coredump-ch/dancepads/Elektronik/2017/Stückliste.xlsx

Bauteil | Menge | Name | Beschreibung | Gehäuse | Kaufort
U1 | 1 | PIC18F23K22-I/SS | Microcontroller | SSOP-28 | http://ch.farnell.com/microchip/pic18f23k22-i-ss/mcu-8bit-pic18f-64mhz-ssop-28/dp/2315851
U2 | 1 | MCP2221A | USB-I2C converter | TSSOP-14 | http://ch.farnell.com/microchip/mcp2221a-i-st/interface-br-cke-usb-zu-i2c-uart/dp/2678461
C1 | 1 | 10 uF Keko | Stützkondensator | 0805 | http://ch.farnell.com/murata/grm21br61c106ke15k/kondensator-mlcc-x5r-10uf-16v/dp/2611940
C2 | 1 | 470 nF Keko | Stützkondensator | 0603 | http://ch.farnell.com/walsin/0603f474z160ct/kondensator-mlcc-y5v-0-47uf-16v/dp/2496876RL
C3, C16 | 2 | 100 nF Keko | Stützkondensator | 0603 | http://ch.farnell.com/kemet/c0603c104k4rac7081/kondensator-mlcc-x7r-0-1uf-16v/dp/2522597RL
U3 | 1 | NC7SZ332 | OR-Gate | SC-70 | http://ch.farnell.com/on-semiconductor/nc7sz332p6x/ic-sm-logik-nc7sz-or-gate/dp/1607793
J1, J2, J3 | 3 | 68021-208HLF | Verbindung Slave-Slave IN | 2.54 mm Stiftleiste 8-Pin | http://ch.farnell.com/amphenol-fci/68021-208hlf/board-to-board-header-8-position/dp/1924210
J4 | 1 | SSW-104-02-G-D-RA | Verbindung Slave-Slave OUT | 2.54 mm Stiftbuchse 8-Pin | http://ch.farnell.com/samtec/ssw-104-02-g-d-ra/buchse-2-54mm-90-zwei-8kont/dp/1668343
LED1, LED2 | 2 | 1.6x0.8mm SMD CHIP LED LAMP | LED Rot | 0603 | http://ch.farnell.com/kingbright/kp-1608src-prv/led-red-30mcd-640nm-smd/dp/2463989
R5, R6 | 2 | 150 Ohm R | Vorwiderstand | 0603 | ch.farnell.com/multicomp/mcwr06x1500ftl/dickschichtwiderstand-150-ohm/dp/2447255RL
J5 | 1 | USB B | USB Stecker | USB-B | http://ch.farnell.com/multicomp/usb-b-s-ra/usb-2-0-buchse-typ-b-tht/dp/2112373?MER=sy-me-pd-mi-alte
R13, R14, R15 -22, R43 - 45 | 13 | 10 kOhm R | Pull up Widerstand | 0603 | http://ch.farnell.com/multicomp/mcwr06x1002ftl/dickschichtwiderstand-10k-1-0/dp/2447230
J6 | 1 | 68016-106HLF | Programmierverbindung | 2.54 mm Stiftleiste 6-Pin | http://ch.farnell.com/amphenol-fci/68016-106hlf/steckv-stiftleiste-6pos-1-reihe/dp/2751386
D9, D10, D11, D12 | 4 | BZV55-C4V7 | Zenerdiode | SOD-80C | http://ch.farnell.com/nexperia/bzv55-c4v7-115/zener-diode-0-5w-4-7v-sod-80c/dp/1097200RL
D1 - 3, D9 - 12, D17 - 20 | 12 | CD0603-B0340R | Shottky Diode | 0603 | http://ch.farnell.com/bourns/cd0603-b0340r/schottky-diode-1fach-40v-0603/dp/2807975
LED3 - 6 | 4 | ASMT-YTD7-0AA02 | RGB-LED | Speziell | http://ch.farnell.com/broadcom-limited/asmt-ytd7-0aa02/led-plcc6-rgb-650-1900-384-mcd/dp/2368162
Q5 - Q7 | 3 | SSM3K7002F | Treiber FET | SOT23 | http://ch.farnell.com/toshiba/ssm3k7002f-t5l-f-t/mosfet-n-kanal-0-2a-60v-sot23/dp/1714383
R27 & 28, R30 & 31, R33 & 34, R36 &37 | 8 | 47 Ohm R | Vorwiderstand | 0603 | http://ch.farnell.com/multicomp/mcwr06x47r0ftl/dickschichtwiderstand-47r-1-0/dp/2447378
R9, R29, R32, R35 | 4 | 120 Ohm R | Vorwiderstand | 0603 | http://ch.farnell.com/multicomp/mcwr06x1200ftl/dickschichtwiderstand-120-ohm/dp/2447240
 | 4 | Piezos | 7BB-20-6 | 2 Pins | https://www.distrelec.ch/de/piezo-element-murata-7bb-20/p/13787033?q=*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
Einmalig:
 | 1 | PICkit 3 |  |  | http://ch.farnell.com/microchip/pg164130/debugger-pickit-3-usb-programmer/dp/1771323
 | 10 | Piezos | 7BB-12-9 | 0.378 | https://www.distrelec.ch/de/piezo-element-murata-7bb-12/p/13787017?q=*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
 | 10 | Piezos | 7BB-15-6 | 0.2592 | https://www.distrelec.ch/de/piezo-element-murata-7bb-15/p/13787025?q=*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
 | 10 | Piezos | 7BB-20-6 | 0.5076 | https://www.distrelec.ch/de/piezo-element-murata-7bb-20/p/13787033?q=*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
 | 10 | Piezos | 7BB-20-6L0 | 1.22 | https://www.distrelec.ch/de/piezo-element-murata-7bb-20-6l0/p/13787041?q=*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
 | 10 | Piezos | 7BB-27-4 | 0.972 | https://www.distrelec.ch/de/piezo-element-murata-7bb-27/p/13787058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
 | 10 | Piezos | 7BB-35-3 | 0.6912 | https://www.distrelec.ch/de/piezo-element-murata-7bb-35/p/13787066?q=*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
 | 10 | Piezos | 7BB-35-3C | 1.3 | https://www.distrelec.ch/de/piezo-element-murata-7bb-35-3c/p/13787074?q=*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
