coredump-ch/dancepads/Elektronik/2014_old/Schema+PCB/LED_Adapter.step

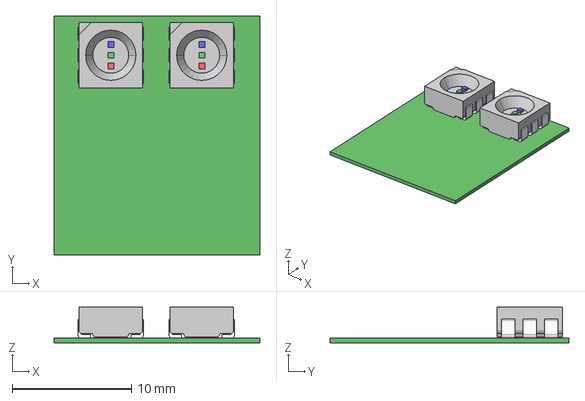
[picture p2: CAD file, 2017-11-20, an earlier design]
Elektronik/2014_old/Schema+PCB/LED_Adapter.step
17.2 x 20.0 x 2.98 mm
Board
User_Library-Cree_PLCC6_LED_model x 2
