coredump-ch/dancepads/Elektronik/2017/Layout/Layout_Dancepad.pdf

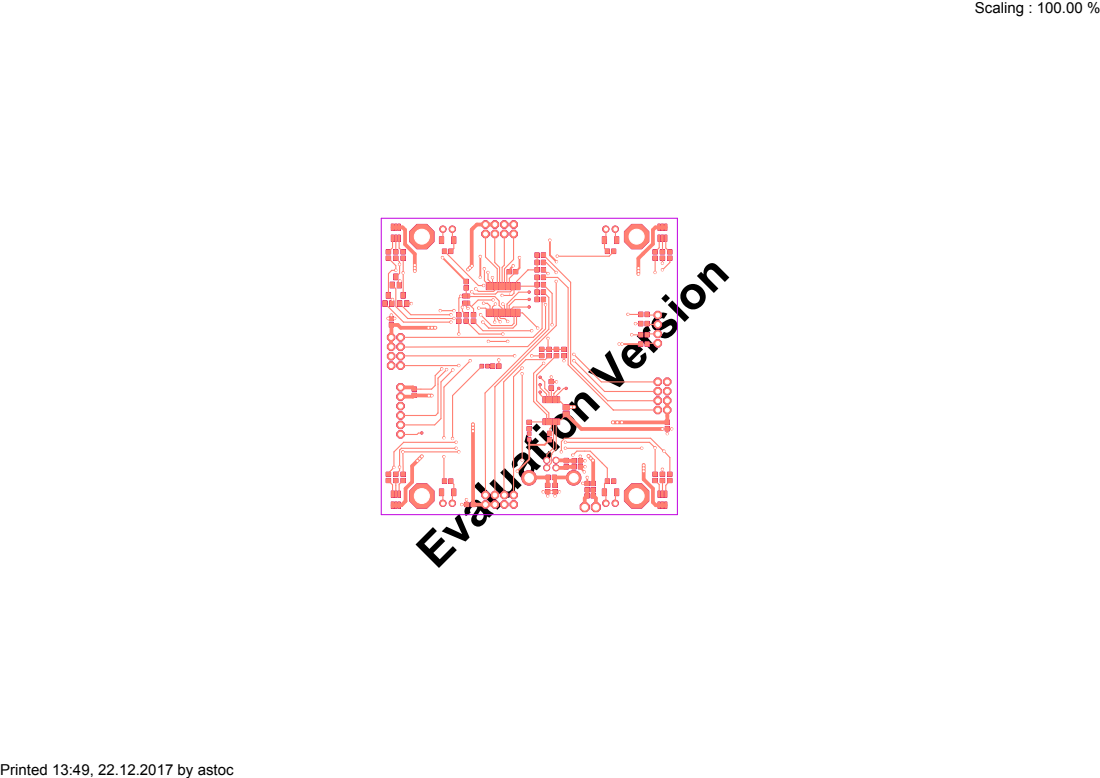
[picture p3: page 1]
Evaluation Version; Scaling : 100.00 %

Printed 13:49, 22.12.2017 by astoc

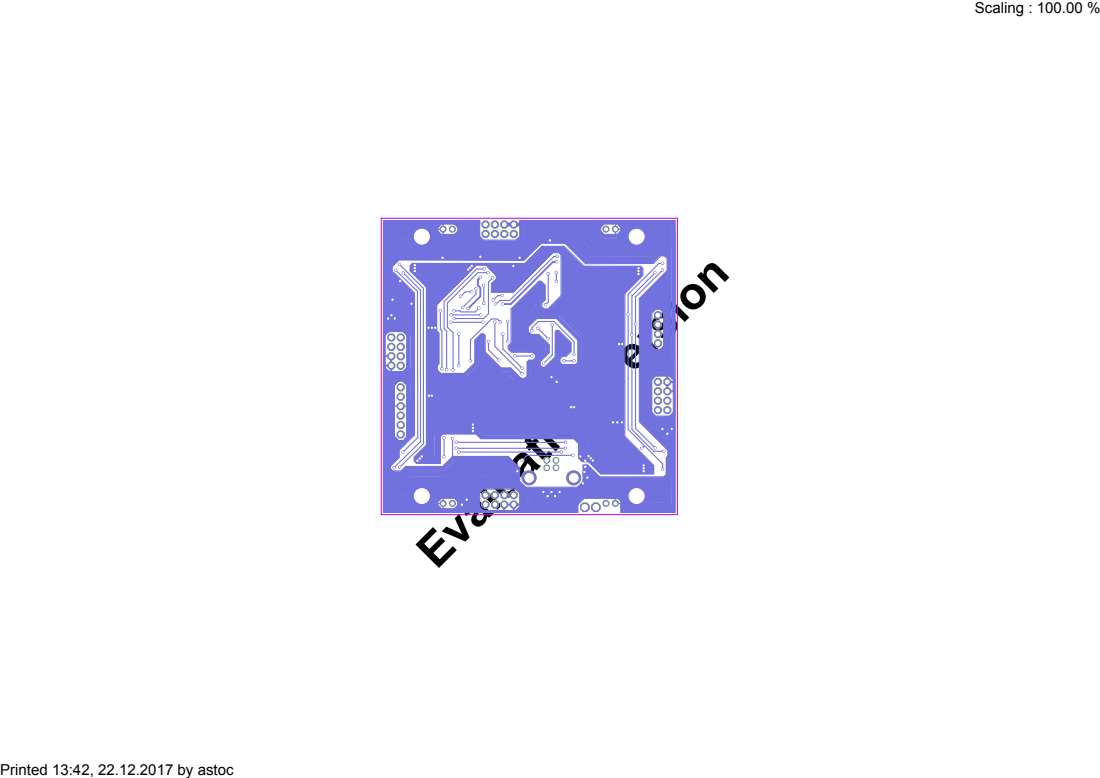
[picture p4: page 2]
Evaluation Version; Scaling : 100.00 %

Printed 13:42, 22.12.2017 by astoc
