coredump-ch/dancepads/Elektronik/2017/Schema/Dancepad_Schematics.pdf

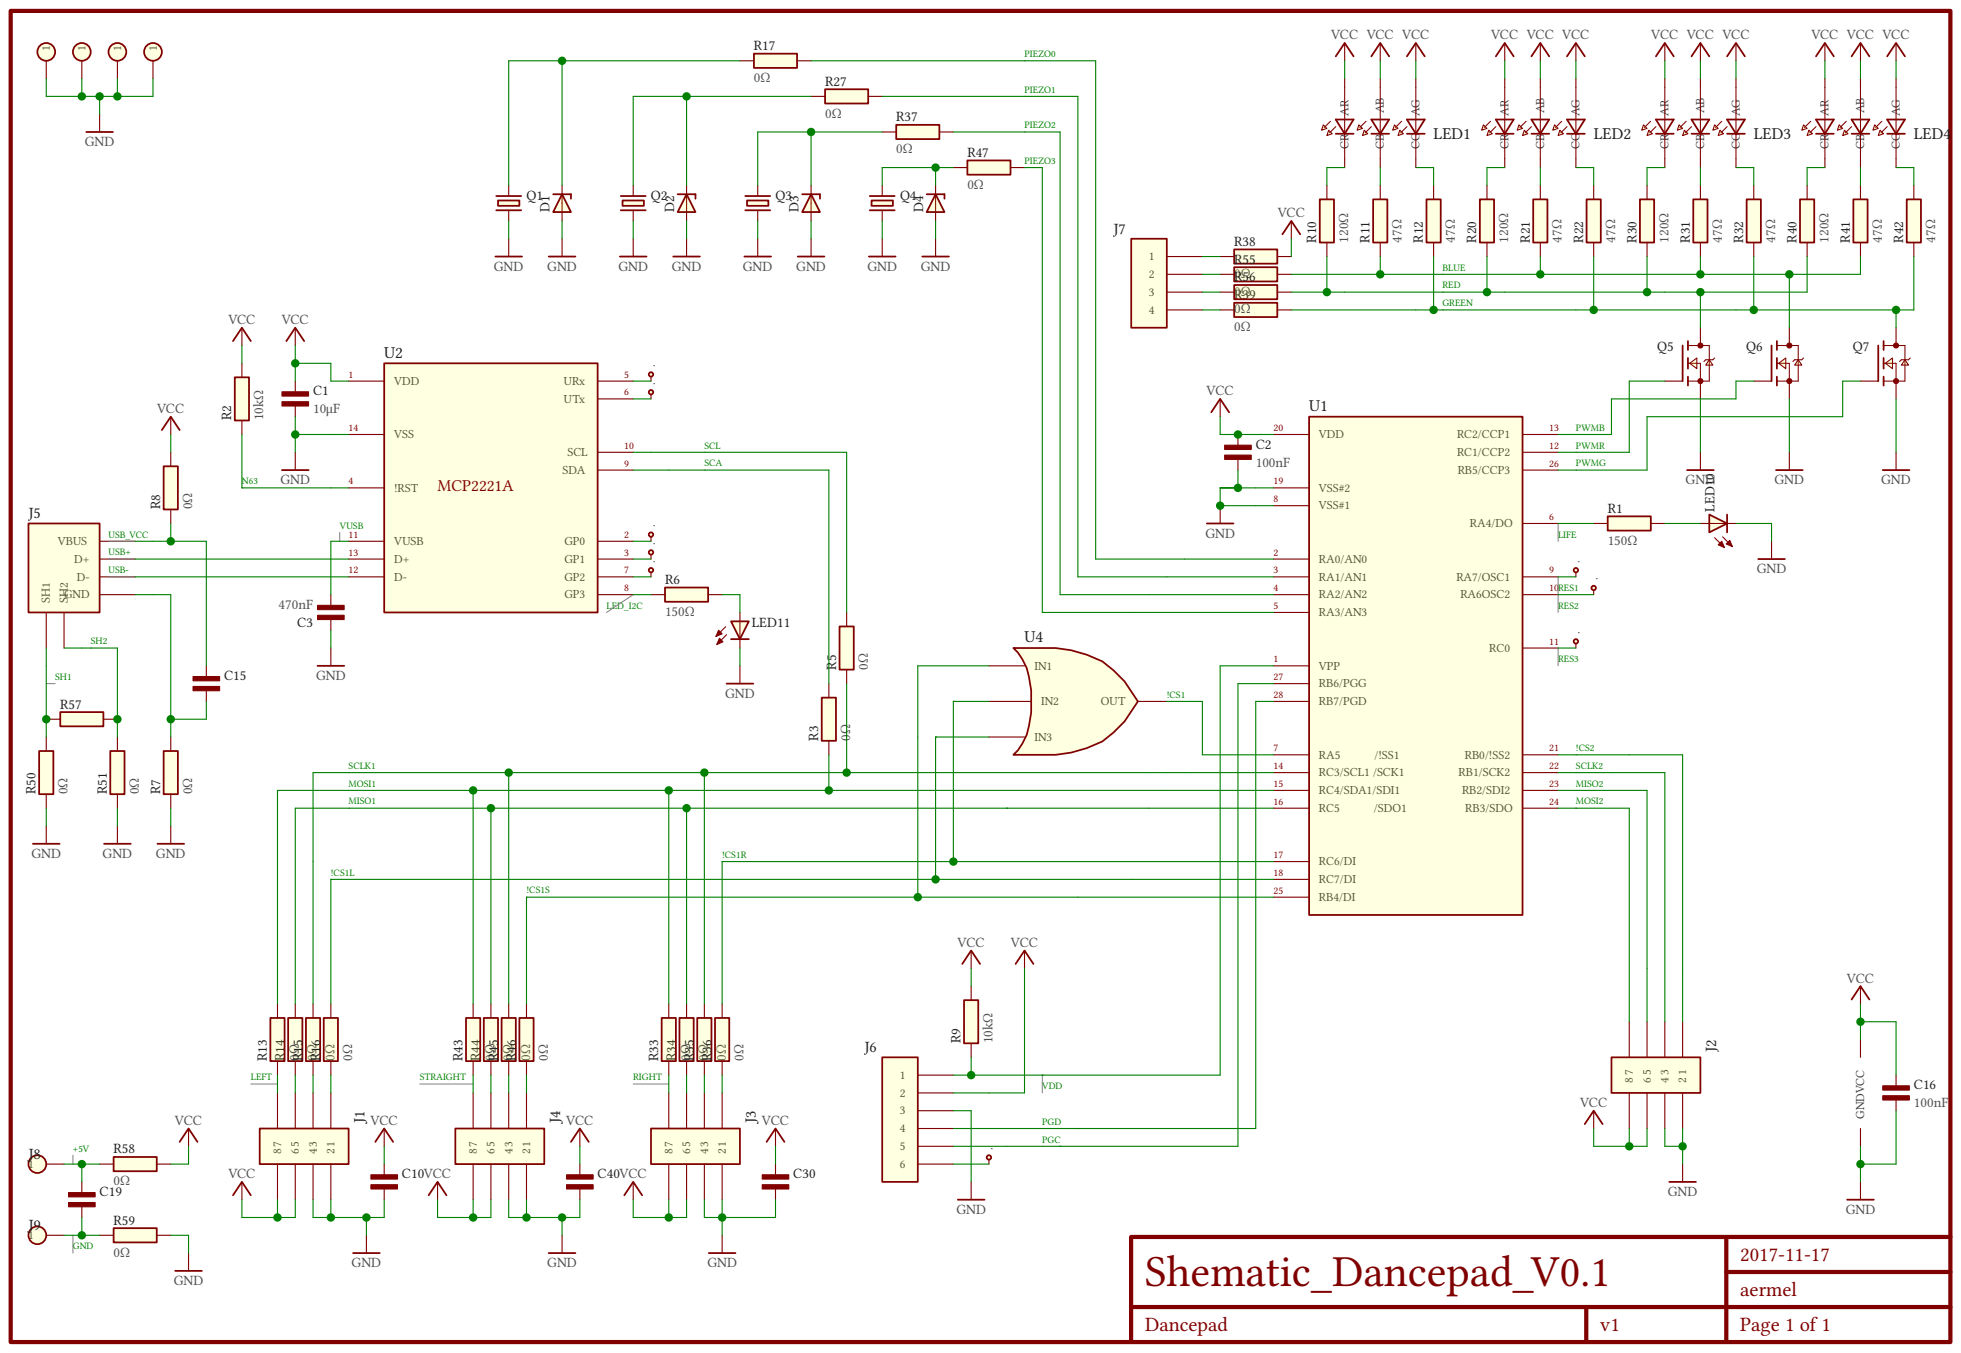
[picture p5: page 1]

RED
GREEN

14 | | 22 SCLK2

MOSI1 | | | | | | | 15 | 23 MISO2
MISO1 | | | | | | | 16 | 24 MOSI2

VCC
