coredump-ch/dancepads/Elektronik/2014_old/SPI Schema.pdf

## PC Interface

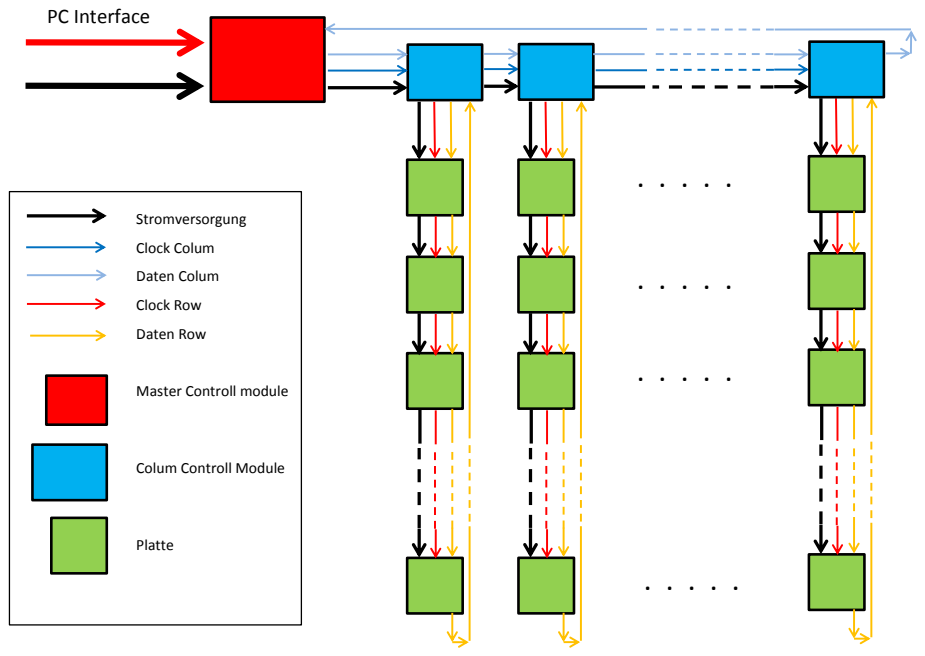
[picture p6: page 1]
Stromversorgung; Clock Colum; Daten Colum; Clock Row; Daten Row; Platte

Master Controll module

Colum Controll Module
