coredump-ch/dancepads/(list of files, drawings)

Other design files:
Elektronik/2014_old/Schema+PCB/DanceFloor (In Konflikt stehende Kopie von Josua Schmid 2012-06-01).PrjPcb
Elektronik/2014_old/Schema+PCB/DanceFloor.PrjPcb
Elektronik/2014_old/Schema+PCB/LED_Adapter (In Konflikt stehende Kopie von Josua Schmid 2012-06-01).PcbDoc
Elektronik/2014_old/Schema+PCB/LED_Adapter (In Konflikt stehende Kopie von Josua Schmid 2012-06-01).SchDoc
Elektronik/2014_old/Schema+PCB/LED_Adapter.PcbDoc
Elektronik/2014_old/Schema+PCB/LED_Adapter.SchDoc
