coredump-ch/dancepads/Software/2019/Dancepad_CEO/Dancepad/hsi.h

/**
 * HSI -> RGB color conversion.
 *
 * Copyright (c) 2014 Danilo Bargen
 *
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
 * THE SOFTWARE IS PROVIDED “AS IS”, WITHOUT WARRANTY OF ANY KIND, EXPRESS OR
 * IMPLIED, INCLUDING BUT NOT LIMITED TO THE WARRANTIES OF MERCHANTABILITY,
 * FITNESS FOR A PARTICULAR PURPOSE AND NONINFRINGEMENT. IN NO EVENT SHALL THE
 * AUTHORS OR COPYRIGHT HOLDERS BE LIABLE FOR ANY CLAIM, DAMAGES OR OTHER
 * LIABILITY, WHETHER IN AN ACTION OF CONTRACT, TORT OR OTHERWISE, ARISING
 * FROM, OUT OF OR IN CONNECTION WITH THE SOFTWARE OR THE USE OR OTHER DEALINGS
 * IN THE SOFTWARE.
 */

#pragma once


struct RGB {
	int r;
	int g;
	int b;
};

struct HSI {
    float h;
    float s;
    float i;
};

/**
 * Function example takes H, S and I. It will return a RGB struct
 * that has three members called r, g and b.
 *
 * The input intervals are the following:
 *
 * H -- [0, 360]
 * S -- [0, 1]
 * I -- [0, 1]
 *
 * Source: http://blog.saikoled.com/post/43693602826/why-every-led-light-should-be-using-hsi
 */
RGB hsi2rgb(float H, float S, float I);

HSI rgb2hsi(int R, int G, int B);
