coredump-ch/dancepads/Elektronik/2017/Firmware/C/Project/Dancepad.X/rgbled.h

/* 
 * File:   rgbled.h
 * Author: astoc
 *
 * Created on 12. Dezember 2017, 15:26
 */

#ifndef RGBLED_H
#define	RGBLED_H
 
//Init RGB LED subroutine
void init_rgbled();

//Blink RGB LED subroutine
void set_rgbled(int r, int g, int b);

#endif
