coredump-ch/dancepads/(commit log)

2017-11-20 Copied Project in Coredump folder. Lost all old commits....
    [DanceFloor (In Konflikt stehende Kopie von Josua Schmid 2012-06-01).PrjPcb, DanceFloor.PrjPcb, LED_Adapter (In Konflikt stehende Kopie von Josua Schmid 2012-06-01).PcbDoc, LED_Adapter (In Konflikt stehende Kopie von Josua Schmid 2012-06-01).SchDoc, LED_Adapter.PcbDoc, LED_Adapter.SchDoc, LED_Adapter.step, Stückliste.xlsx]
2017-11-29 Bestellung der Bauteile
    [Stückliste.xlsx]
2017-12-04 Tested and evaluated piezo sensors
    [Stückliste.xlsx]
2017-12-12 Implement flashing light
    [Stückliste.xlsx]
2017-12-15 added flashing RGB LED
2017-12-22 Finish layout and schematic
    [Dancepad_COPPER-BOTTOM.gbr, Dancepad_COPPER-TOP.gbr, Dancepad_DRILLS-PTH.drl, Dancepad_OUTLINES.gbr, Dancepad_SILKSCREEN-BOTTOM.gbr, Dancepad_SILKSCREEN-TOP.gbr, Dancepad_SOLDERMASK-BOTTOM.gbr, Dancepad_SOLDERMASK-TOP.gbr]
2018-01-08 Change gerber file ending
    [Dancepad.gbl, Dancepad.gbo, Dancepad.gbs, Dancepad.gko, Dancepad.gtl, Dancepad.gto, Dancepad.gts]
2018-01-15 Added RGB PWM
2018-01-15 Implemented ADC Conversion
    [Stückliste.xlsx]
2018-03-19 Added SPI files; Optical optimisation
2018-04-19 Implement first version of SPI communication
2018-07-02 Implement SPI communication
2019-10-30 Implemented Receiving data of I2C Slave.
2019-11-01 Receiving and transmitting of I2C (USB) Data implemented
2019-11-02 Comment added on Logbook, the way it is possible to insert the library on the Visual Studio IDE.
2019-11-03 CEO & Master: I2C/USB Sending data from Master to CEO from Single-Byte to Multi-Byte implemented
2019-11-03 CEO & Master: I2C/USB Receiving data from Master to CEO changed from single byte communication to multi byte communication
2019-12-07 Implemented Trend Zoom. It's still realy buggy and it needs to be checked again. Additionally, in dancpad.h needs to be checked if all these includes are necessary.
    [dancepad.cpp, dancepad.h]
2019-12-12 Fix Bugs on plot zoom
    [dancepad.cpp, dancepad.h]
2019-12-12 Implemented Time x-Axis on plot
2019-12-15 implemented HSI and RGB color changing. Unfortunatelly, it is still buggy.
    [dancepad.cpp, dancepad.h, hsi.cpp, hsi.h]
2019-12-16 Solved problem with strange movement of scroll bars.
    [DP_Communication.cpp, dancepad.cpp]
2019-12-16 optimized Piezo ADC's
2019-12-18 Changed value axis from integer to voltage; Changed time axis from relative time to absolut time; temporarily fixed problem with left-right-straight initialization.
    [dancepad.cpp, dancepad.h, init.c]
2019-12-19 Optimized piezo readings; Implemented, that AD conversion only works, if it requested by I2C; Renamed Piezos the same way as in the CEO program.
2019-12-23 Fixed RGB HSI convertion error at Saturation = 0.
    [hsi.cpp]
2019-12-27 USB communication establishment with pushbutton implemented; Rename states of state machine properly; Bugfix of saturation and intensity value.
    [dancepad.cpp, dancepad.h]
2019-12-27 Implemented life LED synchronization on CEO
2019-12-27 Life LED controlling from CEO implemented.
2019-12-27 Implement Life LED Synch between CEO and Master
2019-12-28 Split main programm into master and slave; added specific life led in dependency of direction
2019-12-30 Implement SPI Communication between Masters and Slave. Please Optimize it later!
